cousinben6/Autonomous-IOT-Enabled-Vehicle/motor_functions.h

//------------------------------------------------------------------------------
//
//  Description: This file contains motor private functions to toggle them on and off.
//
//  Benjamin Ryle
//  Sept 2019
//  Built with IAR Embedded Workbench Version: V7.3.1.3987 (6.40.1)
//------------------------------------------------------------------------------
#include  "functions.h"
#include  "msp430.h"
