cousinben6/Autonomous-IOT-Enabled-Vehicle/motors.h

//possible angle values in main.c


//when i program this, 1 will be empty, 5 will be full battery. for now? slow med fast.

#define MOTOR_OFF (3)
#define motor_disabled (3)


//power divisions for motors at different PWM values
#define reverse (0)
#define forward (1)

#define slow (0)
#define med (1)
#define fast (2)

#define slowL1 (7000)
#define slowR1 (7000)
#define medL1 (8000)
#define medR1 (11000)
#define fastL1 (20000)
#define fastR1 (20000)

#define slowL2 (4000)
#define slowR2 (4000)
#define medL2 (9000)
#define medR2 (6000)
#define fastL2 (10000)
#define fastR2 (10000)

#define slowL3 (4000)
#define slowR3 (4000)
#define medL3 (9500)
#define medR3 (6000)
#define fastL3 (15000)
#define fastR3 (15000)

#define slowL4 (4000)
#define slowR4 (4000)
#define medL4 (10000)
#define medR4 (6000)
#define fastR4 (15000)
#define fastL4 (15000)

#define slowL5 (4000)
#define slowR5 (4000)
#define medL5 (10000)
#define medR5 (5000)
#define fastL5 (15000)
#define fastR5 (15000)

#define slowL6 (4000)
#define slowR6 (4000)
#define medL6 (1100)
#define medR6 (5000)
#define fastL6 (15000)
#define fastR6 (15000)

#define slowL7 (1500)
#define slowR7 (1500)
#define medL7 (6000)
#define medR7 (6000)
#define fastL7 (11000)
#define fastR7 (11000)
